RXTX4816/OBDisplay-Uno/docs/wiki/Home.md

# OBDisplay-Uno Wiki

KWP-1281 K-Line trip computer for Arduino Uno with SH1107 OLED display. Reads live sensor data and fault codes from VAG vehicles (Golf Mk4, Bora, Jetta, ~1998–2006) over the K-Line OBD interface.

## Pages

| Page | Description |
|---|---|
| [Hardware Setup](Hardware-Setup) | Wiring, components, K-Line cable modification |
| [Getting Started](Getting-Started) | Flash pre-built firmware or build from source |
| [Operation](Operation) | Startup and navigation overview |
| [Screen Reference](Screen-Reference) | Every screen explained: layouts, buttons, DTC decoding, settings |
| [KWP-1281 Protocol](KWP-1281-Protocol) | Protocol details, ECU addresses, measurement groups |
| [Development](Development) | Build environments, debug logging, project structure, CI |
| [Troubleshooting](Troubleshooting) | Common issues and fixes |

## Quick links

- [Releases](https://github.com/RXTX4816/OBDisplay-Uno/releases) — pre-built firmware `.hex` files
- [OBDisplay-Emu](https://github.com/RXTX4816/OBDisplay-Emu) — KWP-1281 ECU emulator for bench testing
- [README](https://github.com/RXTX4816/OBDisplay-Uno#readme)
