RXTX4816/OBDisplay-Uno/assets/InkedKKL-cable-back_edited.jpg

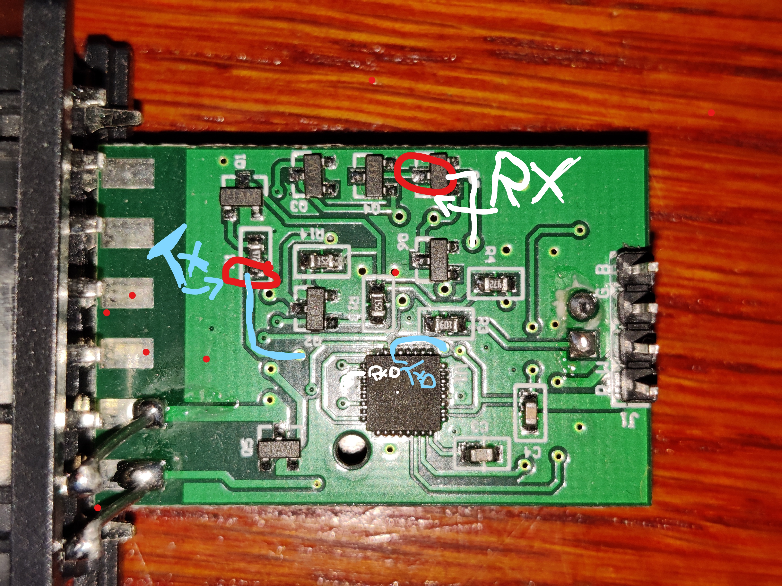
assets/InkedKKL-cable-back_edited.jpg
