RXTX4816/OBDisplay-Uno/assets/InkedKKL-cable-front_edited.jpg

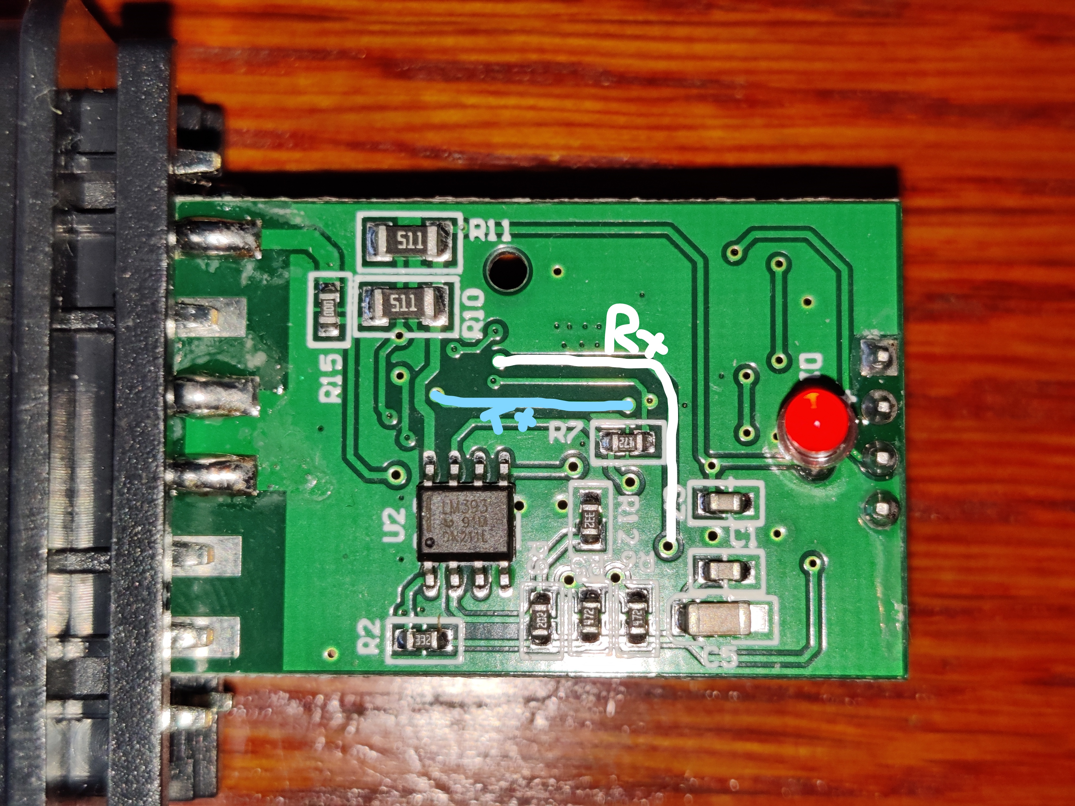
assets/InkedKKL-cable-front_edited.jpg
