RXTX4816/OBDisplay-Uno/src/display/Display.cpp

// SPDX-License-Identifier: GPL-3.0-or-later
#include "Display.h"
#include "../debug.h"
#include <avr/io.h>

namespace
{
constexpr uint8_t OLED_I2C_ADDR = 0x3C;

// Minimal blocking TWI driver — master TX only, single fixed address.
// Replaces Arduino Wire (~1.3 KB) for write-only OLED communication.
//
// Every wait is bounded and every step checks the TWI status: noise on long
// SDA/SCL wires can leave TWINT unset forever or NACK a byte. The first failure
// sets twiOk = false and turns the rest of the transfer into no-ops; flush()
// then resets the bus and the OLED and sends the frame again.
static bool twiOk = true;
static uint8_t twiErrors = 0; // failed frames since boot, saturating

static void twiInit()
{
    PORTC |= (1 << PC4) | (1 << PC5); // pull-ups on SDA/SCL
    TWSR = 0;                         // prescaler = 1
    TWBR = 72;                        // 100 kHz @ 16 MHz: (16e6/100e3 - 16) / 2
}

// Start one TWI action and wait for it; ~30 ms timeout (one byte takes ~90 µs).
static bool twiStep(uint8_t ctrl, uint8_t expectStatus)
{
    if (!twiOk)
        return false;
    TWCR = ctrl;
    uint16_t n = 0;
    while (!(TWCR & (1 << TWINT)))
    {
        if (--n == 0)
            return twiOk = false;
    }
    if ((TWSR & 0xF8) != expectStatus)
        twiOk = false;
    return twiOk;
}

static void twiByte(uint8_t b, uint8_t expectStatus)
{
    if (!twiOk)
        return;
    TWDR = b;
    twiStep((1 << TWINT) | (1 << TWEN), expectStatus);
}

static void twiStart(uint8_t addr)
{
    if (twiStep((1 << TWINT) | (1 << TWSTA) | (1 << TWEN), 0x08)) // START sent
        twiByte((uint8_t)(addr << 1), 0x18);                      // SLA+W, ACK
}

static void twiWrite(uint8_t b)
{
    twiByte(b, 0x28); // data, ACK
}

static void twiStop()
{
    if (!twiOk)
        return;
    TWCR = (1 << TWINT) | (1 << TWEN) | (1 << TWSTO);
    uint16_t n = 0;
    while (TWCR & (1 << TWSTO))
    {
        if (--n == 0)
        {
            twiOk = false;
            return;
        }
    }
}

// Free a bus left mid-byte: hand the pins back from the TWI unit, clock SCL 9×
// so a slave holding SDA low finishes its byte, then send START + STOP.
// Pins are driven open-drain: PORT bit 0, DDR selects low (1) or released (0).
static void twiRecover()
{
    TWCR = 0;
    PORTC &= ~((1 << PC4) | (1 << PC5));
    for (uint8_t i = 0; i < 9; ++i)
    {
        DDRC |= (1 << PC5);
        delayMicroseconds(5);
        DDRC &= ~(1 << PC5);
        delayMicroseconds(5);
    }
    DDRC |= (1 << PC4); // SDA low while SCL high: START
    delayMicroseconds(5);
    DDRC &= ~(1 << PC4); // SDA released while SCL high: STOP
    delayMicroseconds(5);
    twiInit();
    twiOk = true;
}

// SH1107 initialization sequence (from U8g2 driver, proven working).
// Each command is sent individually with delays for stability.
const uint8_t PROGMEM kInit[] = {
    0xAE,       // display off
    0xDC, 0x00, // display start line = 0 (SH1107 specific)
    0x81, 0x2F, // contrast = 0x2F (reasonable brightness)
    0x20,       // memory addressing mode: page
    0xA1,       // segment remap
    0xC8,       // COM output scan direction
    0xA8, 0x7F, // multiplex ratio = 128 (full height)
    0xD3, 0x00, // display offset = 0
    0xD5, 0x51, // clock divide ratio / oscillator frequency
    0xD9, 0x22, // pre-charge period
    0xDB, 0x35, // VCOMH deselect level
    0xDA, 0x12, // COM pins configuration
    0xA4,       // output follows RAM (not forced all-on)
    0xA6,       // normal display (non-inverted)
    0xAF,       // display on
};

// 5x7 font: one byte per column, 5 columns per character, 1-pixel gap.
// ASCII 0x20 (space) through 0x7F.
const uint8_t PROGMEM kFont[] = {
    0x00, 0x00, 0x00, 0x00, 0x00, // 0x20 space
    0x00, 0x00, 0x5F, 0x00, 0x00, // !
    0x00, 0x07, 0x00, 0x07, 0x00, // "
    0x14, 0x7F, 0x14, 0x7F, 0x14, // #
    0x24, 0x2A, 0x7F, 0x2A, 0x12, // $
    0x23, 0x13, 0x08, 0x64, 0x62, // %
    0x36, 0x49, 0x55, 0x22, 0x50, // &
    0x00, 0x05, 0x03, 0x00, 0x00, // '
    0x00, 0x1C, 0x22, 0x41, 0x00, // (
    0x00, 0x41, 0x22, 0x1C, 0x00, // )
    0x14, 0x08, 0x3E, 0x08, 0x14, // *
    0x08, 0x08, 0x3E, 0x08, 0x08, // +
    0x00, 0x50, 0x30, 0x00, 0x00, // ,
    0x08, 0x08, 0x08, 0x08, 0x08, // -
    0x00, 0x60, 0x60, 0x00, 0x00, // .
    0x20, 0x10, 0x08, 0x04, 0x02, // /
    0x3E, 0x51, 0x49, 0x45, 0x3E, // 0
    0x00, 0x42, 0x7F, 0x40, 0x00, // 1
    0x42, 0x61, 0x51, 0x49, 0x46, // 2
    0x21, 0x41, 0x45, 0x4B, 0x31, // 3
    0x18, 0x14, 0x12, 0x7F, 0x10, // 4
    0x27, 0x45, 0x45, 0x45, 0x39, // 5
    0x3C, 0x4A, 0x49, 0x49, 0x30, // 6
    0x01, 0x71, 0x09, 0x05, 0x03, // 7
    0x36, 0x49, 0x49, 0x49, 0x36, // 8
    0x06, 0x49, 0x49, 0x29, 0x1E, // 9
    0x00, 0x36, 0x36, 0x00, 0x00, // :
    0x00, 0x56, 0x36, 0x00, 0x00, // ;
    0x00, 0x08, 0x14, 0x22, 0x41, // <
    0x14, 0x14, 0x14, 0x14, 0x14, // =
    0x41, 0x22, 0x14, 0x08, 0x00, // >
    0x02, 0x01, 0x51, 0x09, 0x06, // ?
    0x32, 0x49, 0x79, 0x41, 0x3E, // @
    0x7E, 0x11, 0x11, 0x11, 0x7E, // A
    0x7F, 0x49, 0x49, 0x49, 0x36, // B
    0x3E, 0x41, 0x41, 0x41, 0x22, // C
    0x7F, 0x41, 0x41, 0x22, 0x1C, // D
    0x7F, 0x49, 0x49, 0x49, 0x41, // E
    0x7F, 0x09, 0x09, 0x09, 0x01, // F
    0x3E, 0x41, 0x49, 0x49, 0x7A, // G
    0x7F, 0x08, 0x08, 0x08, 0x7F, // H
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
    0x02, 0x04, 0x08, 0x10, 0x20, // backslash
    0x00, 0x41, 0x41, 0x7F, 0x00, // ]
    0x04, 0x02, 0x01, 0x02, 0x04, // ^
    0x40, 0x40, 0x40, 0x40, 0x40, // _
    0x00, 0x01, 0x02, 0x04, 0x00, // `
    0x20, 0x54, 0x54, 0x54, 0x78, // a
    0x7F, 0x48, 0x44, 0x44, 0x38, // b
    0x38, 0x44, 0x44, 0x44, 0x20, // c
    0x38, 0x44, 0x44, 0x48, 0x7F, // d
    0x38, 0x54, 0x54, 0x54, 0x18, // e
    0x08, 0x7E, 0x09, 0x01, 0x02, // f
    0x0C, 0x52, 0x52, 0x52, 0x3E, // g
    0x7F, 0x08, 0x04, 0x04, 0x78, // h
    0x00, 0x44, 0x7D, 0x40, 0x00, // i
    0x20, 0x40, 0x44, 0x3D, 0x00, // j
    0x7F, 0x10, 0x28, 0x44, 0x00, // k
    0x00, 0x41, 0x7F, 0x40, 0x00, // l
    0x7C, 0x04, 0x18, 0x04, 0x78, // m
    0x7C, 0x08, 0x04, 0x04, 0x78, // n
    0x38, 0x44, 0x44, 0x44, 0x38, // o
    0x7C, 0x14, 0x14, 0x14, 0x08, // p
    0x08, 0x14, 0x14, 0x18, 0x7C, // q
    0x7C, 0x08, 0x04, 0x04, 0x08, // r
    0x48, 0x54, 0x54, 0x54, 0x20, // s
    0x04, 0x3F, 0x44, 0x40, 0x20, // t
    0x3C, 0x40, 0x40, 0x20, 0x7C, // u
    0x1C, 0x20, 0x40, 0x20, 0x1C, // v
    0x3C, 0x40, 0x30, 0x40, 0x3C, // w
    0x44, 0x28, 0x10, 0x28, 0x44, // x
    0x0C, 0x50, 0x50, 0x50, 0x3C, // y
    0x44, 0x64, 0x54, 0x4C, 0x44, // z
    0x00, 0x08, 0x36, 0x41, 0x00, // {
    0x00, 0x00, 0x7F, 0x00, 0x00, // |
    0x00, 0x41, 0x36, 0x08, 0x00, // }
    0x08, 0x04, 0x08, 0x10, 0x08, // ~
    0x00, 0x00, 0x00, 0x00, 0x00, // 0x7F
};

void writeCmd(uint8_t c)
{
    twiStart(OLED_I2C_ADDR);
    twiWrite(0x00); // control byte: command
    twiWrite(c);
    twiStop();
}

// cmdDelayMs: 5 at boot for stability; 0 when re-initializing after a bus error.
void sendInit(uint8_t cmdDelayMs)
{
    for (uint8_t i = 0; i < sizeof(kInit); ++i)
    {
        writeCmd(pgm_read_byte(&kInit[i]));
        delay(cmdDelayMs);
    }
}

} // namespace

// cppcheck-suppress functionStatic
void Display::begin()
{
    DBG(DBG_DISP_INIT);
    twiInit();
    DBG(DBG_DISP_WIRE_OK);

    DBG(DBG_DISP_OFF);
    writeCmd(0xAE);
    delay(100);

    DBG(DBG_DISP_SEQ);
    sendInit(5);
    delay(200); // Post-init stabilization
    DBG(DBG_DISP_INIT_DONE);

    delay(500); // Extra stabilization time

    DBG(DBG_DISP_CLEAR);
    for (uint8_t page = 0; page < 16; ++page)
    {
        writeCmd((uint8_t)(0xB0 | page));
        writeCmd(0x00);
        writeCmd(0x12); // CRITICAL: column high nibble = 0x12

        twiStart(OLED_I2C_ADDR);
        twiWrite(0x40); // control byte: data stream
        for (uint8_t col = 0; col < 64; ++col)
            twiWrite(0x00);
        twiStop();
    }
    DBG(DBG_DISP_READY);
}

void Display::clear()
{
    entryCount_ = 0;
    cursorCol_ = 0;
    cursorRow_ = 0;
    markDirty();
}

void Display::beginBatch()
{
    ++batchDepth_;
}

void Display::endBatch()
{
    if (batchDepth_ > 0 && --batchDepth_ == 0)
        flush();
}

void Display::setCursor(uint8_t col, uint8_t row)
{
    cursorCol_ = col;
    cursorRow_ = row;
}

void Display::addTextEntry(uint8_t x, uint8_t line, const char* text, uint8_t scale)
{
    if (entryCount_ < kMaxEntries)
    {
        TextEntry& e = entries_[entryCount_++];
        e.x = x;
        e.line = line;
        e.scale = scale;
        strncpy(e.text, text, kTextLen - 1);
        e.text[kTextLen - 1] = '\0';
    }
}

void Display::print(const char* s)
{
    if (s == nullptr || entryCount_ >= kMaxEntries)
        return;

    // Convert column to pixel x
    uint8_t px = (uint8_t)(cursorCol_ * 6);
    addTextEntry(px, cursorRow_, s);

    // Advance cursor by length of string
    cursorCol_ += (uint8_t)strlen(s);

    markDirty();
}

void Display::print(const __FlashStringHelper* s)
{
    if (s == nullptr || entryCount_ >= kMaxEntries)
        return;

    // Copy from PROGMEM into local buffer first
    const char* p = reinterpret_cast<const char*>(s);
    char buf[kTextLen];
    uint8_t i = 0;
    char c;
    while (i < kTextLen - 1 && (c = pgm_read_byte(p++)) != '\0')
        buf[i++] = c;
    buf[i] = '\0';

    // Convert column to pixel x
    uint8_t px = (uint8_t)(cursorCol_ * 6);
    addTextEntry(px, cursorRow_, buf);

    // Advance cursor by length of string
    cursorCol_ += i;

    markDirty();
}

void Display::print(int32_t n)
{
    if (entryCount_ >= kMaxEntries)
        return;

    char buf[12];
    ltoa(n, buf, 10);
    print(buf);
}

void Display::printBig(uint8_t x_px, uint8_t y_px, const char* s)
{
    if (s == nullptr || entryCount_ >= kMaxEntries)
        return;
    addTextEntry(x_px, y_px, s, 2);
    markDirty();
}

void Display::printBig(uint8_t x_px, uint8_t y_px, int32_t n)
{
    if (entryCount_ >= kMaxEntries)
        return;
    char buf[12];
    ltoa(n, buf, 10);
    printBig(x_px, y_px, buf);
}

void Display::drawBar(uint8_t x, uint8_t y, uint8_t w, uint8_t h)
{
    if (entryCount_ >= kMaxEntries)
        return;
    TextEntry& e = entries_[entryCount_++];
    e.x = x;
    e.line = y;
    e.scale = 3;
    e.text[0] = (char)w;
    e.text[1] = (char)h;
    markDirty();
}

void Display::drawBarClear(uint8_t x, uint8_t y, uint8_t w, uint8_t h)
{
    if (entryCount_ >= kMaxEntries)
        return;
    TextEntry& e = entries_[entryCount_++];
    e.x = x;
    e.line = y;
    e.scale = 4;
    e.text[0] = (char)w;
    e.text[1] = (char)h;
    markDirty();
}

// cppcheck-suppress functionStatic
void Display::drawChar2xToPage(uint8_t x, uint8_t y, char c, uint8_t page, uint8_t* pageBuf)
{
    if (x >= 64 || y >= 128)
        return;

    // The 14 px tall glyph spans rows y..y+13; shift places it relative to this page.
    int8_t shift = (int8_t)(y - (uint8_t)(page << 3));
    if (shift > 7 || shift < -13)
        return;

    uint8_t glyph = ((uint8_t)c < 0x20 || (uint8_t)c > 0x7F) ? 0 : (uint8_t)(c - 0x20);
    const uint8_t* g = &kFont[(uint16_t)glyph * 5];

    // 5 columns × 2 = 10 pixel-wide glyph (+ 2px gap = 12px per char)
    for (uint8_t col = 0; col < 5; ++col)
    {
        // Each of the 7 font rows becomes 2 pixel rows.
        uint8_t bits = pgm_read_byte(g + col);
        uint16_t tall = 0;
        for (uint8_t row = 0; row < 7; ++row)
            if (bits & (1u << row))
                tall |= (uint16_t)(3u << (row * 2));

        uint8_t mask = shift >= 0 ? (uint8_t)(tall << shift) : (uint8_t)(tall >> -shift);
        uint8_t sx = x + (uint8_t)(col * 2);
        if (sx < 64)
            pageBuf[sx] |= mask;
        if (sx + 1 < 64)
            pageBuf[sx + 1] |= mask;
    }
}

// Small text rows are page aligned (y = line * 8), so a glyph fills exactly one
// page and overwrites its 6 columns whole: 7 font rows, bit 7 clear, 1 gap column.
// cppcheck-suppress functionStatic
void Display::drawCharToPage(uint8_t x, char c, uint8_t* pageBuf)
{
    uint8_t glyph = ((uint8_t)c < 0x20 || (uint8_t)c > 0x7F) ? 0 : (uint8_t)(c - 0x20);
    const uint8_t* g = &kFont[(uint16_t)glyph * 5];

    for (uint8_t cx = 0; cx < 5; ++cx)
        pageBuf[x + cx] = pgm_read_byte(g + cx) & 0x7Fu;
    pageBuf[x + 5] = 0x00;
}

void Display::flush()
{
    if (!dirty_)
        return;

    // A bus error aborts the frame: reset the bus and the OLED (it may have taken
    // stray bytes as commands and shifted its addressing), then send it once more.
    for (uint8_t attempt = 0; attempt < 2; ++attempt)
    {
        sendFrame();
        if (twiOk)
            break;
        if (twiErrors < 255)
            ++twiErrors;
        twiRecover();
        sendInit(0);
    }

    dirty_ = false;
}

uint8_t Display::i2cErrors()
{
    return twiErrors;
}

void Display::sendFrame()
{
    // Render page-by-page
    for (uint8_t page = 0; page < 16; ++page)
    {
        // 64 visible columns + 5 spare: a small-font glyph starting at x=60..63
        // draws up to x+5 (unchecked in drawCharToPage). The spare bytes absorb
        // the clipped columns instead of overwriting the stack; only 64 are sent.
        uint8_t pageBuf[69] = {0};

        // Render all entries into this page
        for (uint8_t t = 0; t < entryCount_; ++t)
        {
            const TextEntry& e = entries_[t];
            uint8_t x = e.x;
            const char* s = e.text;

            if (e.scale == 2)
            {
                uint8_t y = e.line; // raw pixel y for big text
                while (*s && x < 64)
                {
                    drawChar2xToPage(x, y, *s++, page, pageBuf);
                    x += 12; // 10px glyph + 2px gap
                }
            }
            else if (e.scale == 3 || e.scale == 4)
            {
                // scale=3: fill rect (set pixels); scale=4: clear rect (clear pixels).
                // e.line = top y, e.text[0] = width, e.text[1] = height.
                uint8_t by = e.line;
                uint8_t bw = (uint8_t)e.text[0];
                uint8_t bh = (uint8_t)e.text[1];
                uint8_t pageStart = (uint8_t)(page << 3);
                uint16_t byEnd = (uint16_t)by + bh;
                if (by >= pageStart + 8u || byEnd <= pageStart)
                    continue;
                uint8_t yLo = by > pageStart ? by : pageStart;
                uint8_t yHi = (byEnd < pageStart + 8u) ? (uint8_t)byEnd : (uint8_t)(pageStart + 8u);
                uint8_t mask = 0;
                for (uint8_t iy = yLo; iy < yHi; ++iy)
                    mask |= (uint8_t)(1u << (iy & 7u));
                uint8_t xEnd = x + bw;
                if (xEnd > 64u)
                    xEnd = 64u;
                if (e.scale == 3)
                    for (uint8_t ix = x; ix < xEnd; ++ix)
                        pageBuf[ix] |= mask;
                else
                    for (uint8_t ix = x; ix < xEnd; ++ix)
                        pageBuf[ix] &= (uint8_t)~mask;
            }
            else
            {
                uint8_t y = (uint8_t)(e.line * 8); // row to pixel y
                if ((y >> 3) != page)
                    continue;
                while (*s && x < 64)
                {
                    drawCharToPage(x, *s++, pageBuf);
                    x += 6;
                }
            }
        }

        // Send this page over I2C
        writeCmd((uint8_t)(0xB0 | page)); // page address
        writeCmd(0x00);                   // column low = 0
        writeCmd(0x12);                   // column high = 0x12 ← CRITICAL!

        uint8_t col = 0;
        while (col < 64)
        {
            twiStart(OLED_I2C_ADDR);
            twiWrite(0x40); // data stream control byte
            uint8_t n = 0;
            while (col < 64 && n < 16)
            {
                twiWrite(pageBuf[col]);
                ++col;
                ++n;
            }
            twiStop();
        }
    }
}
