RXTX4816/OBDisplay-Uno/src/obd/KWP/KWPBlocks.h

// SPDX-License-Identifier: GPL-3.0-or-later
#pragma once

// Placeholder for shared KWP block constants / helpers if needed later

namespace obd
{
namespace KWP
{

static constexpr uint8_t KWP_MODE_ACK = 0;
static constexpr uint8_t KWP_MODE_READSENSORS = 1;
static constexpr uint8_t KWP_MODE_READGROUP = 2;

} // namespace KWP
} // namespace obd
