RXTX4816/OBDisplay-Uno/(commit log)

2026-05-25 refactor: update ButtonInput to use multiple pins and improve button reading logic
2026-05-25 feat: implement SH1107 display driver with batch rendering support
2026-05-26 fix: make uno work with oled display SH1107 without framebuffer to save memory
    [ButtonInput.h, Controller.cpp, Display.h]
2026-05-26 fix: revert kwp5baudinit sequence to old approach
    [KWP1281Session.cpp]
2026-05-26 fix: improve connectivity and test with OBDisplay-Emu emulator
    [KWP1281Session.cpp, OBDDisplay.cpp, OBDDisplay.h]
2026-05-28 feat: UIUX improvements, connection errors, cicd + semantic releases
    [ButtonInput.cpp, ButtonInput.h, Controller.cpp, Display.cpp]
2026-05-30 fix: first reconnect now works after manual KWP_EXIT (#17)
    [OBDDisplay.cpp]
2026-05-30 fix: reset values on new connection (#20)
    [KWP1281Session.cpp]
2026-05-31 feat: add warnings, fuel calc and more screens and fix odometer group value (#28)
    [Buzzer.h, KWPSensorDecode.cpp, MenuState.h, OBDDisplay.cpp, OBDDisplay.h, OBDSignals.cpp]
2026-06-01 fix: oilpressure warning (#33)
    [OBDSignals.cpp, OBDSignals.h]
2026-06-01 fix: delay when first connecting (#35)
    [OBDDisplay.cpp]
2026-06-01 fix: compute fuel/100km and remaining km through magic (#36)
    [OBDDisplay.cpp, OBDSignals.cpp, OBDSignals.h]
2026-06-02 fix: optimie flash memory, add compiler flags, remove simulation mode, update wiki (#41)
    [Config.h, Controller.cpp, Controller.h, KWP1281Session.cpp]
2026-06-02 fix: implement oil level and bars page in cockpit (#42)
    [Config.h, Display.cpp, Display.h, OBDDisplay_setup.cpp, OBDSignals.cpp]
2026-06-02 fix: fuel calculations for 0x17 (#43)
    [OBDSignals.cpp]
2026-06-04 fix: add back warning screen, improve warning flash (#49)
    [OBDDisplay_setup.cpp]
2026-06-04 feat: display current version and correct name (#50)
    [Config.h, OBDDisplay.cpp, inject_version.py]
2026-06-04 fix: setup screen not select baud after exit when holding button (#51)
    [OBDDisplay_setup.cpp]
2026-09-14 feat: show oil temperature above 100 °C as a number (#59)
    100–110 °C is normal oil temperature under load, so the cockpit now
    prints the value (e.g. "105 O", fits the 64 px width) instead of
    "-WARN-". Coolant keeps the -WARN- display.
2026-09-14 fix: raise oil temperature warning threshold to 111 °C (#58)
    Up to 110 °C is normal on the highway / under high RPM, so the oil hot
    warning now fires from 111 °C. The check is a plain comparison on each
    reading, so jumping past the threshold still warns and the warning
    stays active until the temperature drops below 111 °C again.
    [Config.h, OBDSignals.h]
2026-09-14 fix: stack overflow in small-font renderer freezing settings screen (#57)
    Text reaching column 10 (e.g. "Sensor" in the settings KWP mode row)
    made drawCharToPage write up to 2 bytes past the 64-byte page buffer,
    corrupting the stack on every frame. Pad the buffer so clipped glyph
    columns land in spare bytes.
    [Display.cpp]
2026-09-14 feat: connection presets and persistent boot autoconnect (#60)
    Setup now starts with a preset screen: Manual/off, 0x01 @ 9600 and
    0x17 @ 10400. A preset fills in baud and address and skips to the
    auto-reconnect screen. Pressing DOWN there saves the preset to EEPROM
    byte 2 (0 = off, 1 = 0x01 @ 9600, 2 = 0x17 @ 10400); on boot a saved
    preset skips the setup and connects. Holding SELECT during power-on
    ignores it and opens the setup, where it can be changed or turned off.
    This replaces the old hold-SELECT quick connect to 0x17.
    The setup stages now share one input loop, which keeps the flash
    usage below the previous build and adds UP-back on the baud screen.
    [OBDDisplay.cpp, OBDDisplay.h, OBDDisplay_setup.cpp]
2026-09-17 feat: show range and consumption on 0x17 main dashboard (#61)
    Replace the ambient temperature row on the 0x17 page 0 dashboard with the
    two values that actually matter while driving: km remaining and current
    L/100km. Both rows are factored into a shared printRangeRows() helper that
    page 1 now uses as well, so the layouts stay in sync.
    Page 0 grows from 6 to 7 rows (124 px of 128).
2026-09-17 feat: warning buzzer with per-level beep patterns (#62)
    Drive an active buzzer (e.g. SFM-27) on pin 10 when a new warning
    fires. Level 3 plays 5 × 50 ms, level 2 plays 3 × 30 ms and level 1 is
    silent, with 40 ms gaps. A 30 ms chirp at power-on confirms the wiring.
    Beeps block for the pattern (at most ~410 ms) because the KWP loop can
    stall longer than a beep, so a non-blocking off-edge would stretch
    short beeps unpredictably.
    The pattern follows the highest level among newly fired warnings
    (new WarningState::newLevel), not maxLevel, so a silent warning
    appearing while a critical one is active does not replay the critical
    pattern.
    The two oil level warnings (<20 % critical, <45 % low) ar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
    [Buzzer.cpp, Buzzer.h, Config.h, OBDDisplay.cpp, OBDSignals.cpp, OBDSignals.h, main.cpp]
2026-09-18 fix: spurious critical fuel warnings from tank slosh (#63)
    The fuel warnings compared the raw sender value against the thresholds
    and fired on the first sample below them. With ~10 L in the tank, every
    corner or uneven road pushed the reading under the 4 L critical trip
    point, so the new buzzer beeped a critical alert on practically every
    turn.
    Warnings now read the EMA-smoothed level (which already existed for
    range and consumption) and each threshold gets a dwell counter: the
    level must stay below it for 200 consecutive compute cycles (10 s at
    50 ms) before the warning latches, and a single good sample resets the
    counter. The smoothed value alone is not enough — its ±1 unit per cycle
    f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
    [Config.h, OBDSignals.cpp, OBDSignals.h]
2026-10-03 fix: drop soft-float library pulled in by group 1 RPM calc (#69)
    The 0x01 group 1 special case computed RPM as 0.2f * a * b, the only
    float expression left in the firmware. #13 converted the voltage line
    next to it but missed this one, so the AVR soft-float library (~600
    bytes) stayed linked for a single multiply.
    a * b / 5 gives the same result for all 65,536 input pairs, checked
    against the real avr-libc float code on an emulated ATmega328P. A
    disassembly diff against main shows no other functional change: every
    other difference is a relocated code address.
    Flash: 99.4% -> 97.4% (634 bytes freed). The debug build, which no
    longer fit (100.5%), builds again at 98.6%.
    To keep it that way: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
    [KWP1281Session.cpp, check_no_float.py]
2026-10-03 test: run unit tests on a simulated ATmega328P, fix bugs they found (#70)
    * fix: drop soft-float library pulled in by group 1 RPM calc
    Flash: 99.4% -> 97.4% (634 bytes freed). The debug build, whi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
    [Display.h, KWPSensorDecode.cpp]
2026-10-03 fix: sub-zero temperatures raised the critical coolant-hot warning (#71)
    All six temperature fields were uint8_t. Below 0 °C the decoded value
    wrapped: -5 °C was stored as 251, so on every winter cold start
    computeWarnings() saw coolant > 93 °C and raised COOL HOT at level 3
    with the critical beep pattern, and the dashboard showed -WARN-
    instead of the temperature. Ambient, oil and the 0x01 temperatures
    (incl. the coolant proxy that drives the same warning on 0x01) wrapped
    the same way.
    - coolant, oil, ambient and the three 0x01 temperatures are int16_t
    (int8_t would cap oil temperature at 127 °C)
    - the KWP decoder and the 0x01 group 1 special case store the signed
    value; warnings c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
    [KWP1281Session.cpp, KWPSensorDecode.cpp, OBDSignals.cpp, OBDSignals.h]
2026-10-03 feat: memory report in releases and auto-updated README badges (#74)
    The four RAM/flash badges in the README were hardcoded and edited by
    hand, so they drifted (flash showed 98.6% while main was at 99.4%).
    tools/memory_report.py parses the RAM/Flash lines of
    `pio run -e uno -e uno_debug` and writes:
    - memory.json with both builds, attached to every release as
    OBDisplay-Uno-<version>-memory.json
    - a "Memory usage" section in the release notes, one row per build
    (only the uno build was listed before)
    - four shields.io endpoint badge files, coloured by usage
    (green < 75%, yellow < 90%, orange < 97%, red above)
    The release workflow builds both images (a failing debug build now
    fails the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
    [memory_report.py]
2026-10-03 feat: approval-gated release after every merge to main (#75)
    Releasing meant opening the Actions tab and starting Semantic Release by
    hand, and release.yml still asked for a version input that was only
    needed to bootstrap the first releases. Neither was tied to CI, so a
    release could be cut from a main commit whose checks failed.
    - semantic-release.yml starts by itself when the CI workflow completes
    on main (workflow_run). It only proceeds if CI passed on a push, i.e.
    a merge, so it never shows up in pull request checks. It runs in the
    `release` environment and waits on the run page until a required
    reviewer approves. It checks out and tags the exact commit CI tested.
    Version logi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
2026-10-03 perf: free ~320 bytes of flash without behaviour changes (#76)
    Flash 31,588 -> 31,264 bytes (97.9% -> 96.9%), debug 31,956 -> 31,632
    bytes (99.1% -> 98.1%). RAM unchanged, render+flush stack 127 -> 120 B.
    - Small font: rows are page aligned, so a glyph is six whole column
    bytes on one page. Write them directly instead of per pixel, and
    skip entries whose row is not on the page being flushed.
    - 2x font: build each doubled column once and OR it in with a shift
    instead of per 2x2 block.
    Both renderers produce byte-identical page buffers to the old ones:
    exhaustive host check (1.0e9 cases: every char, x, y, page and three
    buffer fills) plus an edge-case run on an emulated ATmega328P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
    [Display.cpp, Display.h, OBDDisplay_setup.cpp]
2026-10-03 fix: range and consumption no longer jump on tank slosh (#77)
    * fix: range and consumption no longer jump on tank slosh
    On a corner the tank sender drops by several litres, and the smoothed
    fuel level follows it at up to 2.5 L/s. Burned fuel, L/100km, L/h and
    the km-left estimate were all computed from that level, so every turn
    spiked consumption and cut the range (300 km briefly showed 122 km in
    the new test).
    They now read a settled level that adopts the smoothed level only after
    it has stayed above or below it for FUEL_SETTLE_DWELL_CYCLES (200
    cycles, 10 s) in a row; crossing back restarts the count. A corner,
    including the recovery afterwards, is over well within that, so the
    readings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
    [Config.h, OBDSignals.cpp, OBDSignals.h]
2026-10-10 fix: random freeze with garbled screen on the cockpit (#81)
    * fix: random freeze with garbled screen on the cockpit
    Two independent bugs could each freeze the whole firmware mid-frame, leaving
    a half-drawn, displaced picture until the reset button was pressed.
    Display I2C driver: every wait on TWINT/TWSTO spun forever and no status was
    checked. A glitch on the long SDA/SCL wires hung the MCU inside flush(). Waits
    are now bounded (~30 ms), each step checks the TWI status, and a failed frame
    frees the bus (9 SCL clocks + STOP), re-initialises the SH1107 and is sent
    once more.
    KWP receiveBlock_: the inner drain loop kept storing bytes after the block's
    end, so line noise or the start of the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
    [Display.cpp, Display.h, KWP1281Session.cpp, KWP1281Session.h, NewSoftwareSerial.h, OBDDisplay.cpp]
